GadgetReboot/WiFi_Current_Transformer/README.md

# WiFi_Current_Transformer
ESP8266 based current transformer interface using SCT-013<br><br>
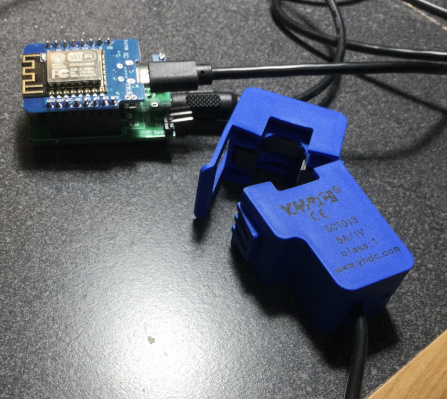
[picture p1: Assembled_PCB.jpg]
pcb
<br><br>
