GadgetReboot/WiFi_Current_Transformer/sketch/readme.md

Sketch to read RMS current and print on serial monitor while generating a triggered output indicator if a minimum current threshold is reached
