GadgetReboot/WiFi_Current_Transformer/GR_Wifi_Current_Trigger_Sch.pdf

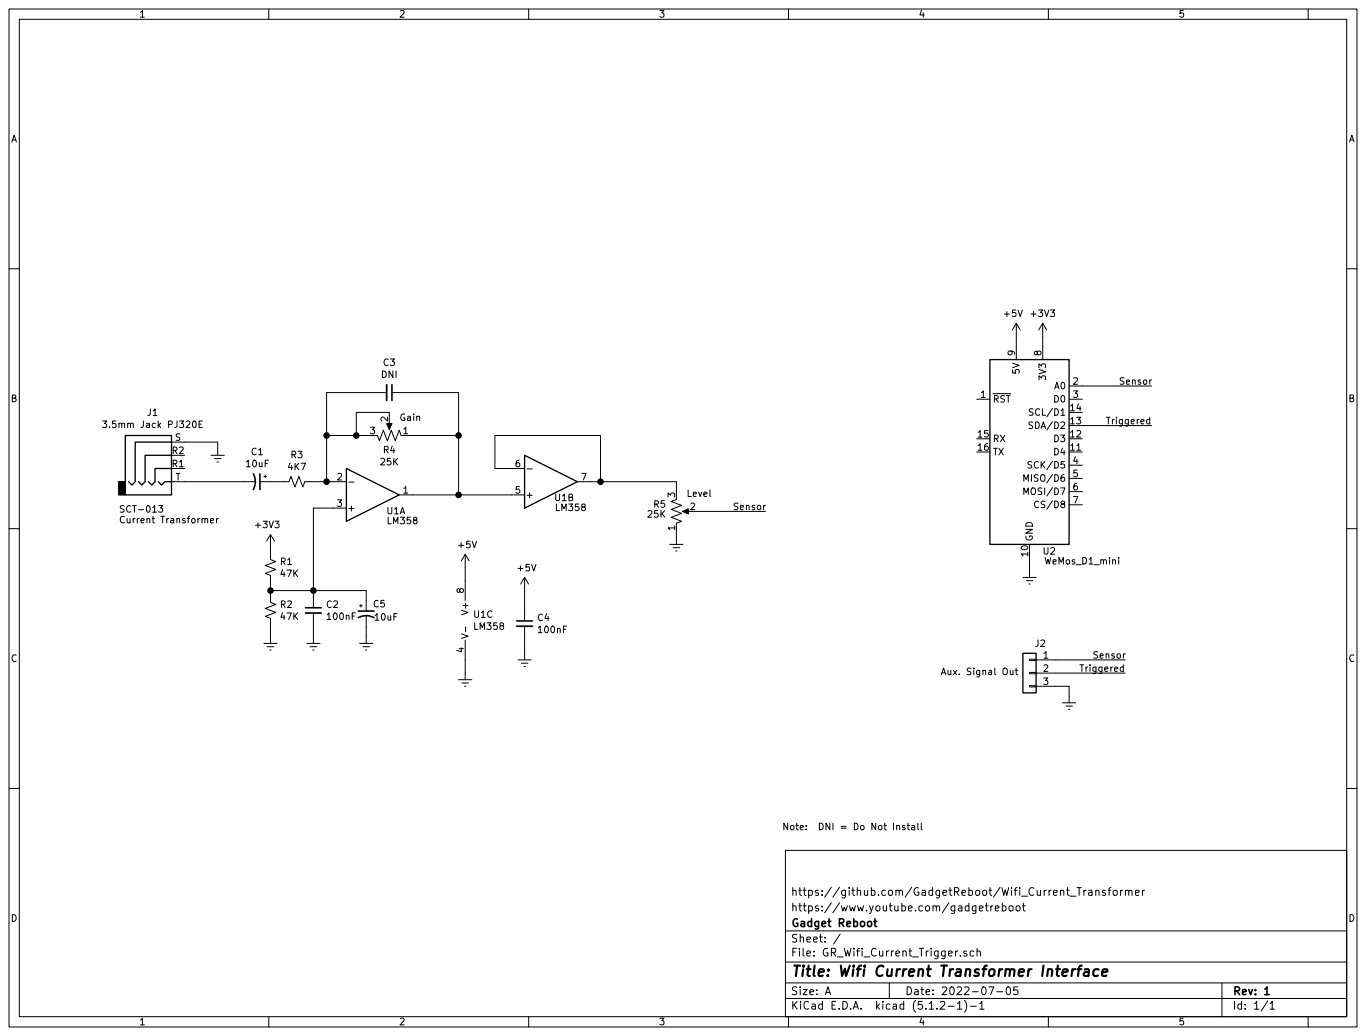
[picture p2: page 1]

https://github.com/GadgetReboot/Wifi_Current_Transformer
https://www.youtube.com/gadgetreboot
File: GR_Wifi_Current_Trigger.sch Sheet: / Gadget Reboot

Id: 1/1 Title: Wifi Current Transformer Interface
