GadgetReboot/WiFi_Current_Transformer/KiCad/GR_Wifi_Current_Trigger.kicad_pcb

## KiCad design KiCad/GR_Wifi_Current_Trigger.kicad_pcb (2022-08-23)

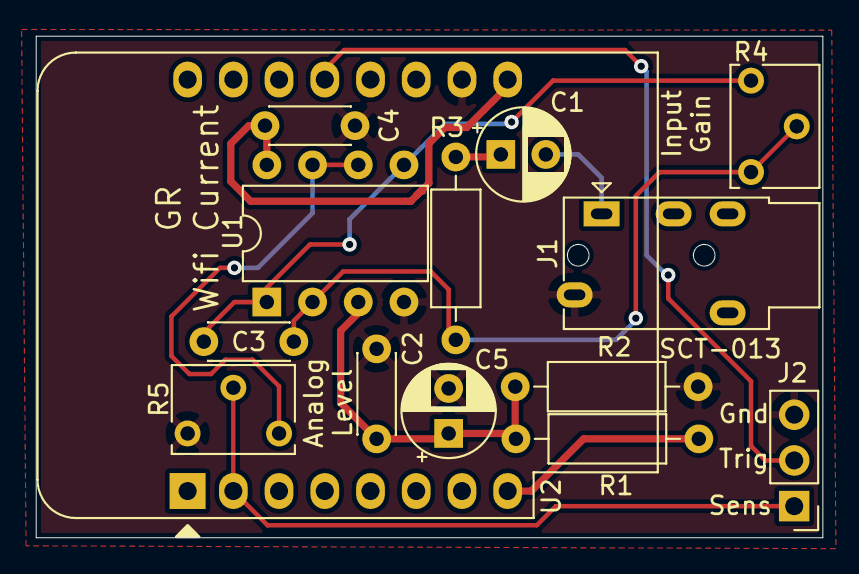
[picture p3: board GR_Wifi_Current_Trigger.kicad_pcb from above]

Board: 2 copper layers, 43.7 x 27.9 mm, 14 parts (0 on the bottom side), 11 nets.

Parts:
C1: 10uF; CP_Radial_D5.0mm_P2.50mm
C2, C4: 100nF; C_Disc_D4.3mm_W1.9mm_P5.00mm
C3: DNI; C_Disc_D4.3mm_W1.9mm_P5.00mm
C5: DNI; CP_Radial_D5.0mm_P2.50mm
J1: 3.5mm Jack; Jack_3.5mm_PJ320E_Horizontal
J2: Conn_01x03; PinHeader_1x03_P2.54mm_Vertical
R1, R2: 47K; R_Axial_DIN0207_L6.3mm_D2.5mm_P10.16mm_Horizontal
R3: 1K; R_Axial_DIN0207_L6.3mm_D2.5mm_P10.16mm_Horizontal
R4, R5: 25K; Potentiometer_Vishay_T73XX_Horizontal
U1: LM358; DIP-8_W7.62mm
U2: WeMos_D1_mini; WEMOS_D1_mini_light

Connections:
+3V3: R1.1, U2.8
+5V: C4.1, U1.8, U2.9
/Sensor: J2.1, R5.2, U2.2
/Triggered: J2.2, U2.13
GNDREF: C2.2, C4.2, C5.2, J1.S, J2.3, R2.2, R5.1, U1.4, U2.10
unnamed: C1.1, R3.2
unnamed: C1.2, J1.T
unnamed: C2.1, C5.1, R1.2, R2.1, U1.3
unnamed: C3.1, R4.1, U1.1, U1.5
unnamed: C3.2, R3.1, R4.2, R4.3, U1.2
unnamed: R5.3, U1.6, U1.7
